atop8918/DigitalWaters_WD_prototype/README.md

# DigitalWaters_WD_prototype
Simplified Schematic for prototype release
