atop8918/DigitalWaters_WD_prototype/board.pdf

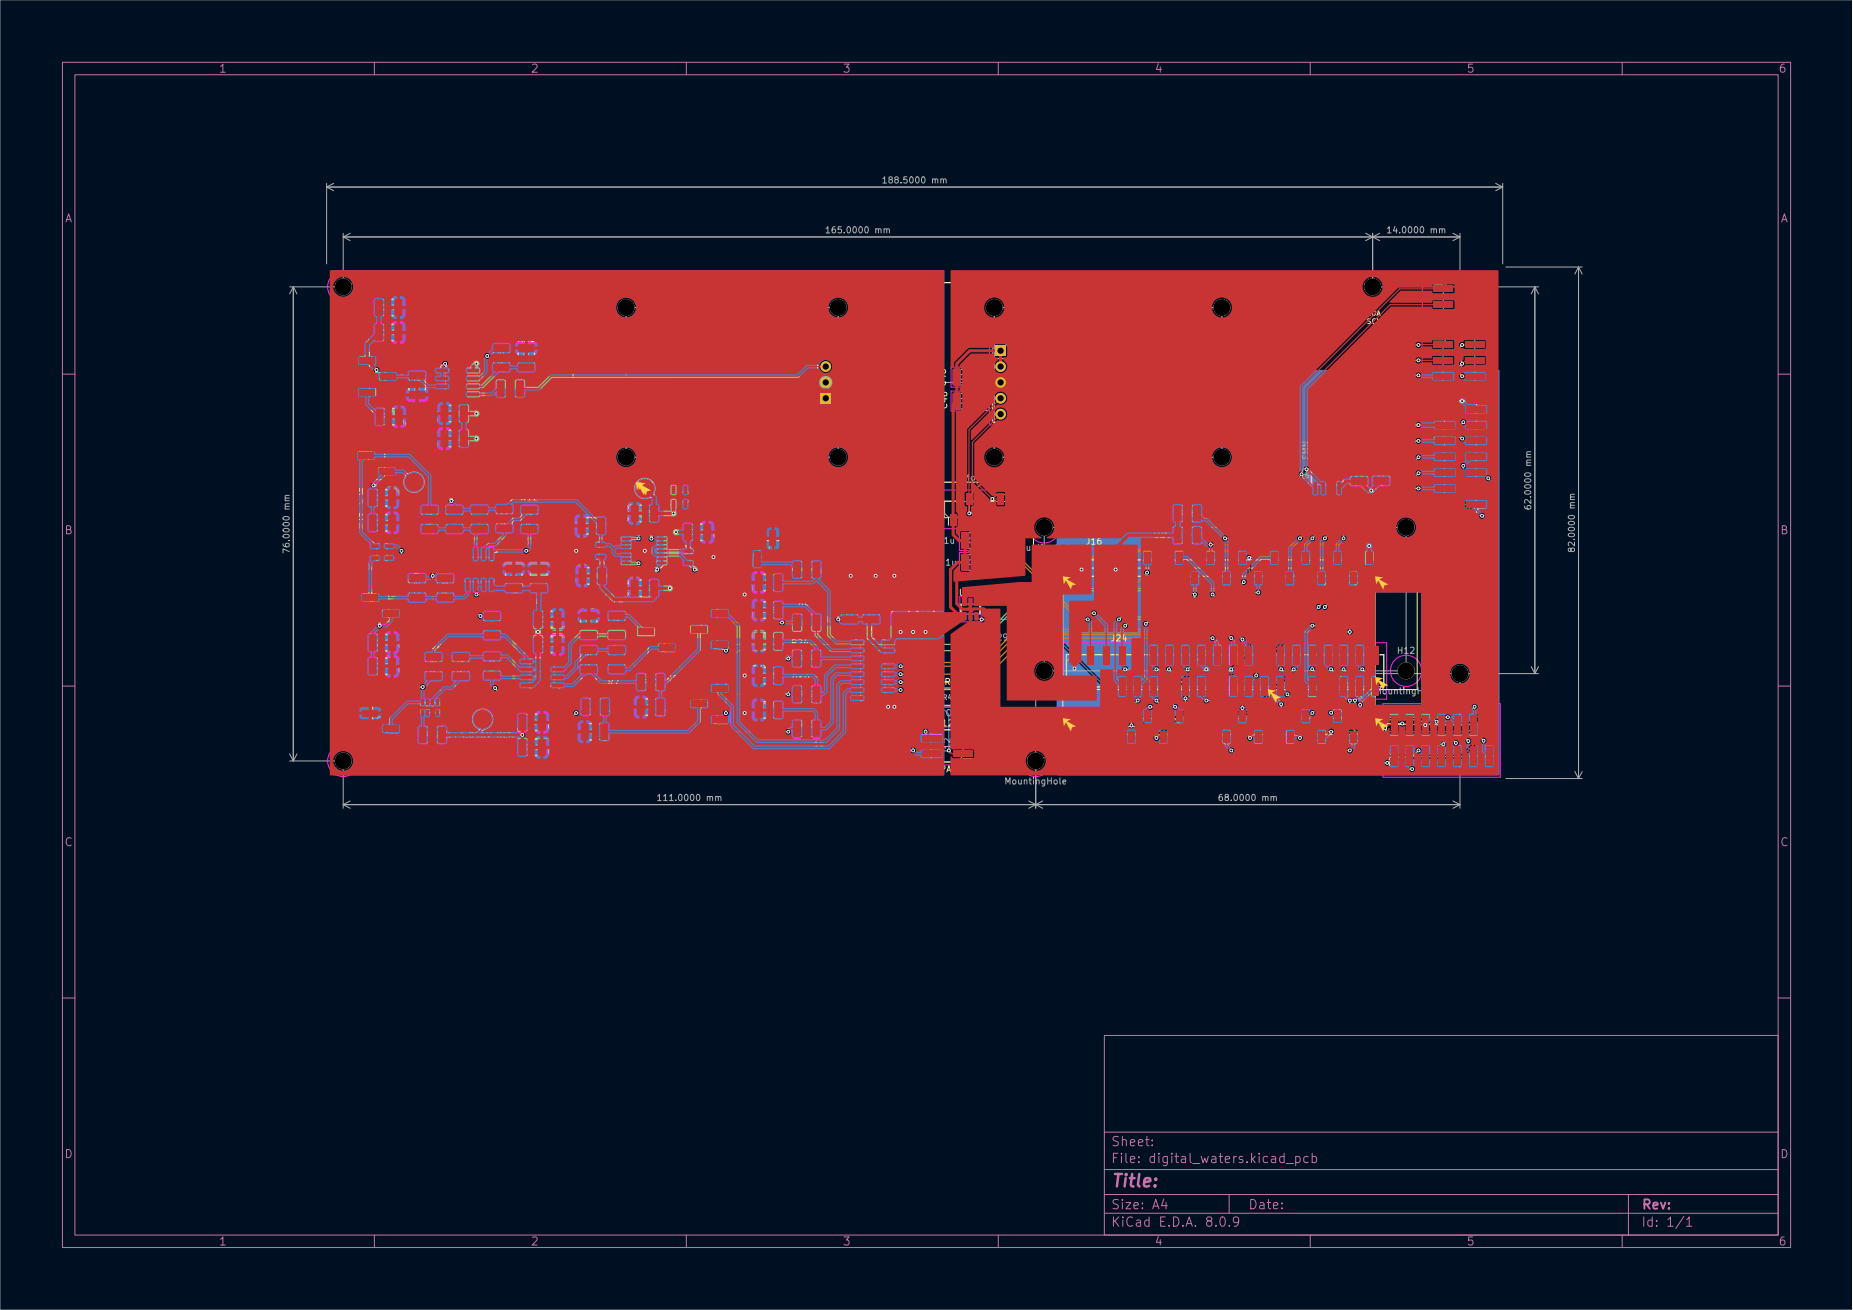
[picture p1: page 1]
