atop8918/DigitalWaters_WD_prototype/digital_waters.kicad_pcb

## KiCad design digital_waters.kicad_pcb (2025-07-22)

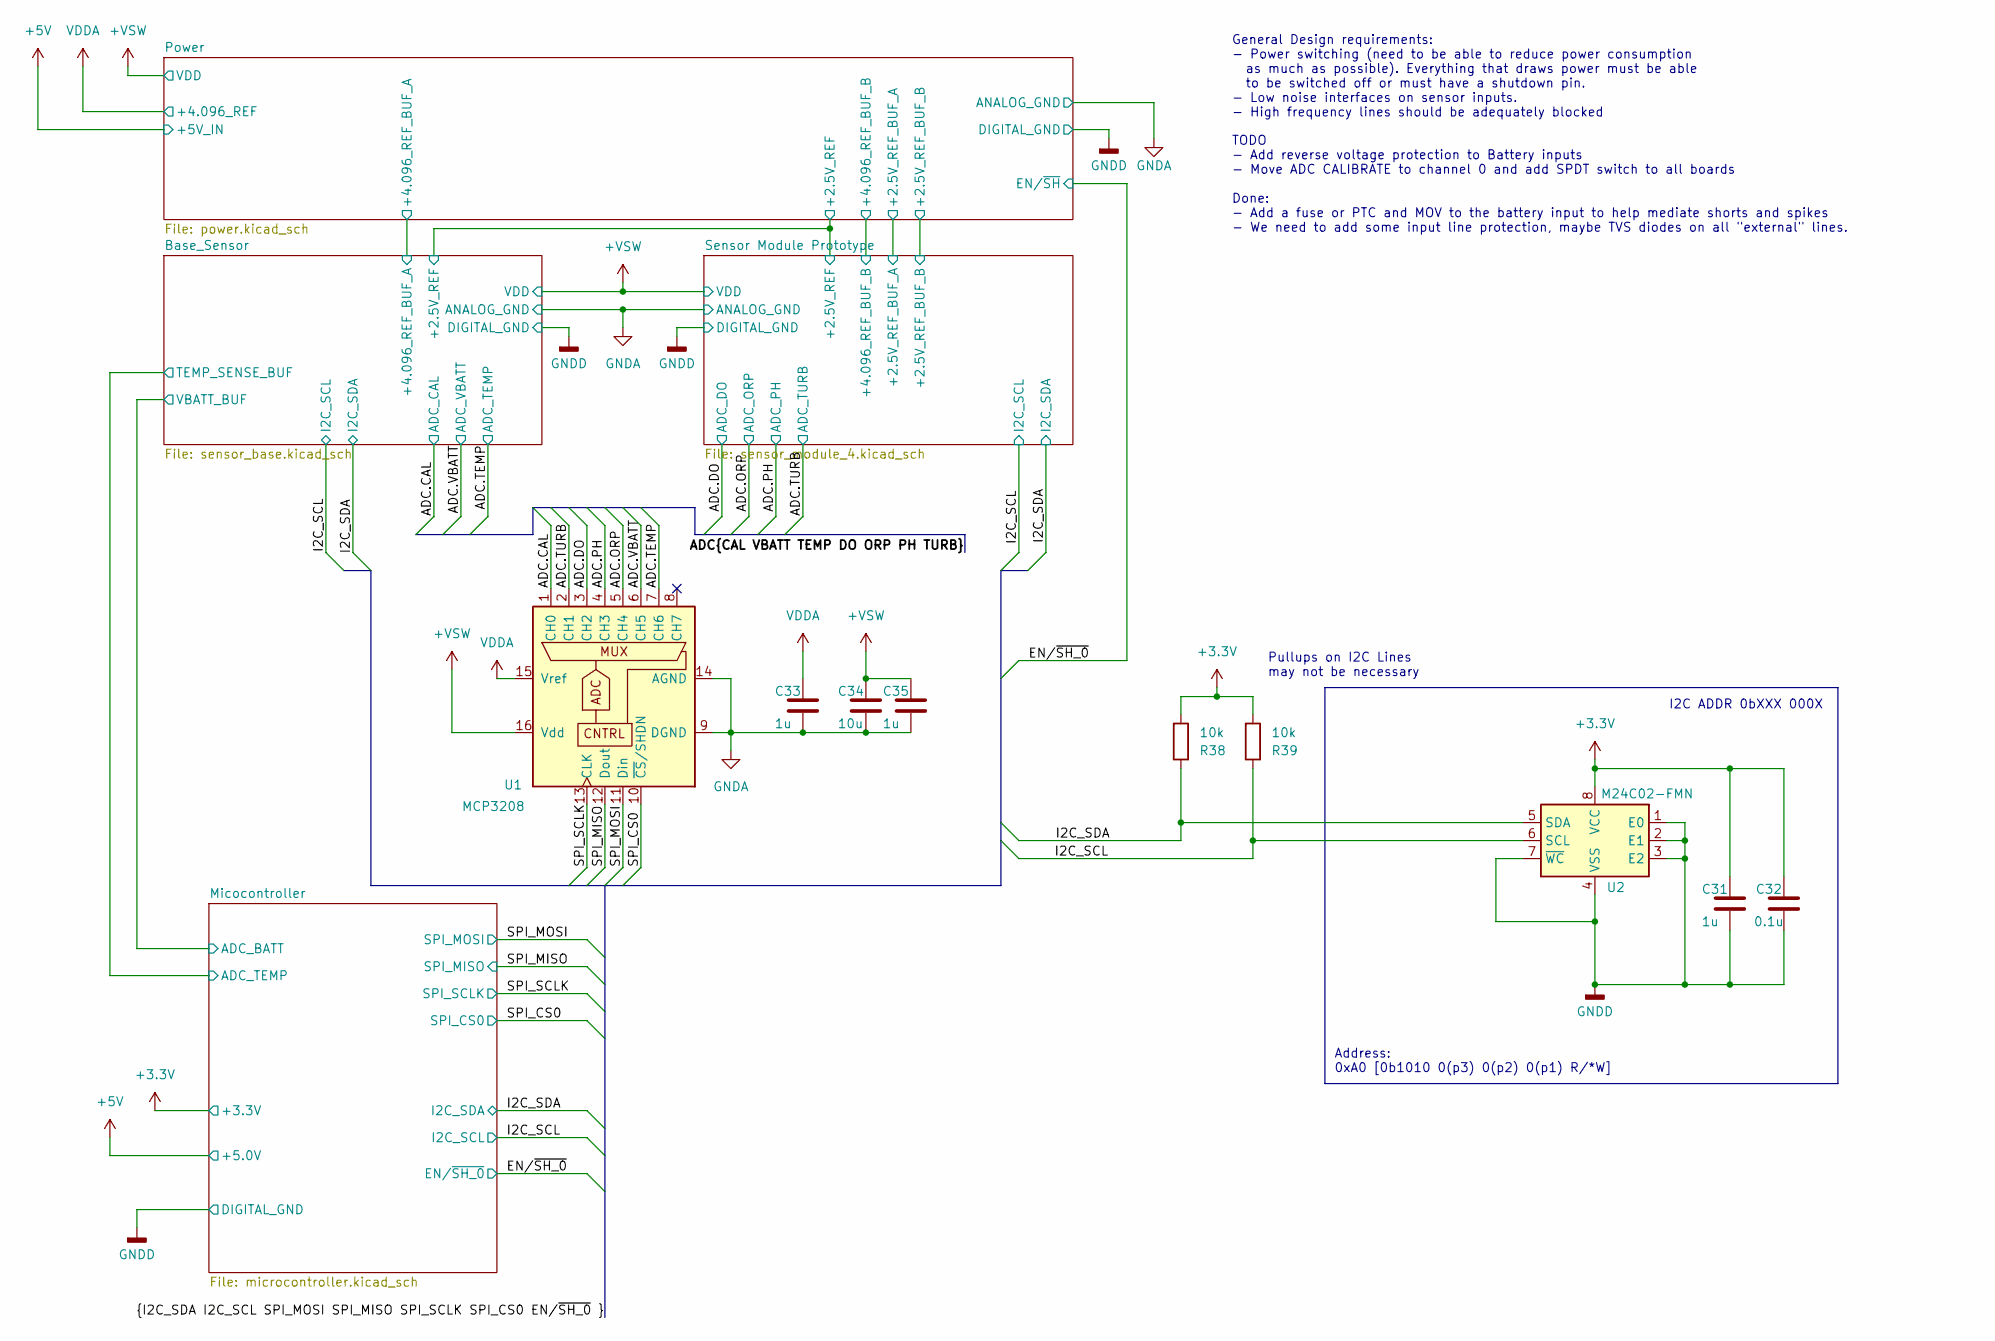
[picture p7: schematic digital_waters.kicad_sch]

Parts:
C31, C33, C35: 1u; C_1210_3225Metric_Pad1.33x2.70mm_HandSolder
C32: 0.1u; C_1210_3225Metric_Pad1.33x2.70mm_HandSolder
C34: 10u; C_1210_3225Metric_Pad1.33x2.70mm_HandSolder
R38, R39: 10k; R_1210_3225Metric_Pad1.30x2.65mm_HandSolder
U1: MCP3208; SOIC-16_3.9x9.9mm_P1.27mm
U2: M24C02-FMN; SOIC-8_3.9x4.9mm_P1.27mm

Connections:
+3.3V: C31.1, C32.1, R38.2, R39.2, U2.8 (VCC); also elsewhere on the board
+VSW: C34.1, C35.1, U1.16 (Vdd); also elsewhere on the board
/ADC.CAL: U1.1 (CH0); also elsewhere on the board
/ADC.DO: U1.3 (CH2); also elsewhere on the board
/ADC.ORP: U1.5 (CH4); also elsewhere on the board
/ADC.PH: U1.4 (CH3); also elsewhere on the board
/ADC.TEMP: U1.7 (CH6); also elsewhere on the board
/ADC.TURB: U1.2 (CH1); also elsewhere on the board
/ADC.VBATT: U1.6 (CH5); also elsewhere on the board
/I2C_SCL: R39.1, U2.6 (SCL); also elsewhere on the board
/I2C_SDA: R38.1, U2.5 (SDA); also elsewhere on the board
/SPI_CS0: U1.10 (~CS/SHDN); also elsewhere on the board
/SPI_MISO: U1.12 (Dout); also elsewhere on the board
/SPI_MOSI: U1.11 (Din); also elsewhere on the board
/SPI_SCLK: U1.13 (CLK); also elsewhere on the board
GNDA: C33.2, C34.2, C35.2, U1.9 (DGND), U1.14 (AGND); also elsewhere on the board
GNDD: C31.2, C32.2, U2.1 (E0), U2.2 (E1), U2.3 (E2), U2.4 (VSS), U2.7 (~WC); also elsewhere on the board
VDDA: C33.1, U1.15 (Vref); also elsewhere on the board

Notes on the sheet:
I2C ADDR 0bXXX 000X
Address: 0xA0 [0b1010 0(p3) 0(p2) 0(p1) R/*W]
TODO - Add reverse voltage protection to Battery inputs - Move ADC CALIBRATE to channel 0 and add SPDT switch to all boards Done: - Add a fuse or PTC and MOV to the battery input to help mediate shorts and spikes - We need to add some input line protection, maybe TVS diodes on all "external" lines.
Pullups on I2C Lines may not be necessary
General Design requirements: - Power switching (need to be able to reduce power consumption as much as possible). Everything that draws power must be able to be switched off or must have a shutdown pin. - Low noise interfaces on sensor inputs. - High frequency lines should be adequately blocked

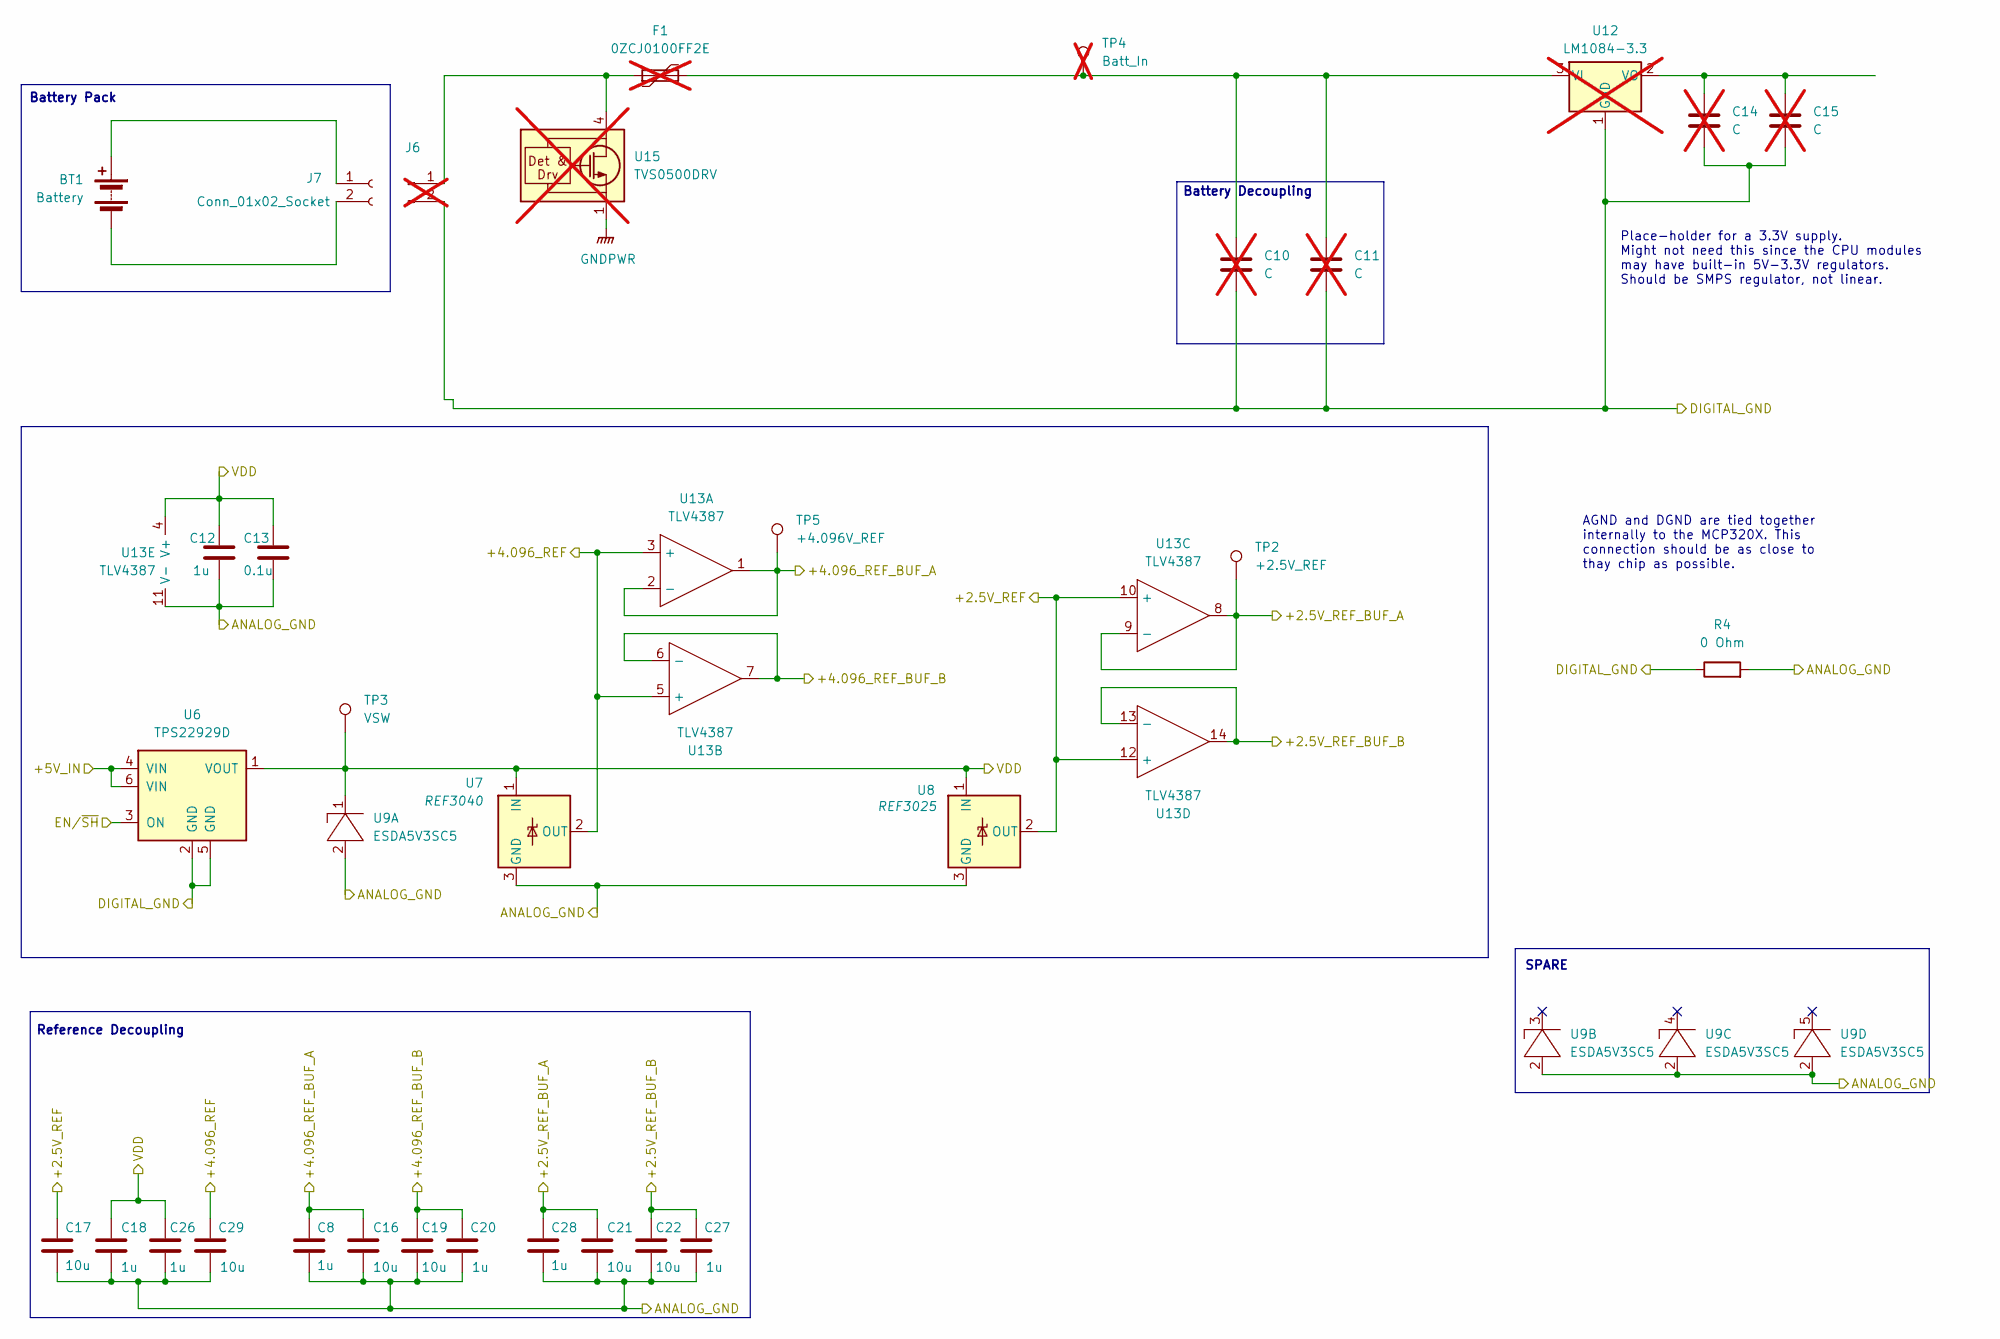
[picture p8: schematic power.kicad_sch]

Parts:
BT1: Battery
C8, C12, C18, C20, C26, C27, C28: 1u; C_1210_3225Metric_Pad1.33x2.70mm_HandSolder
C10, C11, C14, C15: C; C_1210_3225Metric_Pad1.33x2.70mm_HandSolder; not fitted
C13: 0.1u; C_1210_3225Metric_Pad1.33x2.70mm_HandSolder
C16, C17, C19, C21, C22, C29: 10u; C_1210_3225Metric_Pad1.33x2.70mm_HandSolder
F1: 0ZCJ0100FF2E; Fuse_1206_3216Metric_Pad1.42x1.75mm_HandSolder; not fitted
J6: Battery In; PinHeader_1x02_P2.54mm_Vertical_SMD_Pin1Left; not fitted
J7: Conn_01x02_Socket
R4: 0 Ohm; R_1210_3225Metric_Pad1.30x2.65mm_HandSolder
TP2: +2.5V_REF; TestPoint_Pad_D3.0mm
TP3: VSW; TestPoint_Pad_D3.0mm
TP4: Batt_In; TestPoint_Pad_D3.0mm; not fitted
TP5: +4.096V_REF; TestPoint_Pad_D3.0mm
U6: TPS22929D; SOT-23-6
U7: REF3040; SOT-23
U8: REF3025; SOT-23
U9: ESDA5V3SC5; SOT-23-5
U12: LM1084-3.3; PinHeader_2x10_P2.54mm_Vertical_SMD; not fitted
U13: TLV4387; TSSOP-14_4.4x5mm_P0.65mm
U15: TVS0500DRV; WSON-6-1EP_2x2mm_P0.65mm_EP1x1.6mm; not fitted

Connections:
+5V: U6.4 (VIN), U6.6 (VIN); also elsewhere on the board
+VSW: C12.1, C13.1, C18.1, C26.1, TP3.1, U6.1 (VOUT), U7.1 (IN), U8.1 (IN), U9.1, U13.4 (V+); also elsewhere on the board
/Base_Sensor/+2.5V_REF: C17.1, U8.2 (OUT), U13.10 (+), U13.12 (+); also elsewhere on the board
/Base_Sensor/+4.096_REF_BUF_A: C8.1, C16.1, TP5.1, U13.1, U13.2 (-); also elsewhere on the board
/EN/~SH_0: U6.3 (ON); also elsewhere on the board
/Power/+2.5V_REF_BUF_A: C21.1, C28.1, TP2.1, U13.8, U13.9 (-); also elsewhere on the board
/Power/+2.5V_REF_BUF_B: C22.1, C27.1, U13.13 (-), U13.14; also elsewhere on the board
/Power/+4.096_REF_BUF_B: C19.1, C20.1, U13.6 (-), U13.7; also elsewhere on the board
GNDA: C8.2, C12.2, C13.2, C16.2, C17.2, C18.2, C19.2, C20.2, C21.2, C22.2, C26.2, C27.2, C28.2, C29.2, R4.2, U7.3 (GND), U8.3 (GND), U9.2, U13.11 (V-); also elsewhere on the board
GNDD: C10.2, C11.2, C14.2, C15.2, J6.2, R4.1, U6.2 (GND), U6.5 (GND), U12.1 (GND); also elsewhere on the board
unnamed: BT1.1 (+), J7.1
unnamed: BT1.2 (-), J7.2
unnamed: C10.1, C11.1, F1.2, TP4.1, U12.3 (VI)
unnamed: C14.1, C15.1, U12.2 (VO)
unnamed: F1.1, J6.1, U15.4 (IN), U15.5 (IN), U15.6 (IN)
unnamed: U15.1 (GND), U15.2 (GND), U15.3 (GND), U15.7 (GND)
VDDA: C29.1, U7.2 (OUT), U13.3 (+), U13.5 (+); also elsewhere on the board

Notes on the sheet:
Battery Pack
Place-holder for a 3.3V supply. Might not need this since the CPU modules may have built-in 5V-3.3V regulators. Should be SMPS regulator, not linear.
Battery Decoupling
AGND and DGND are tied together internally to the MCP320X. This connection should be as close to thay chip as possible.
SPARE
Reference Decoupling

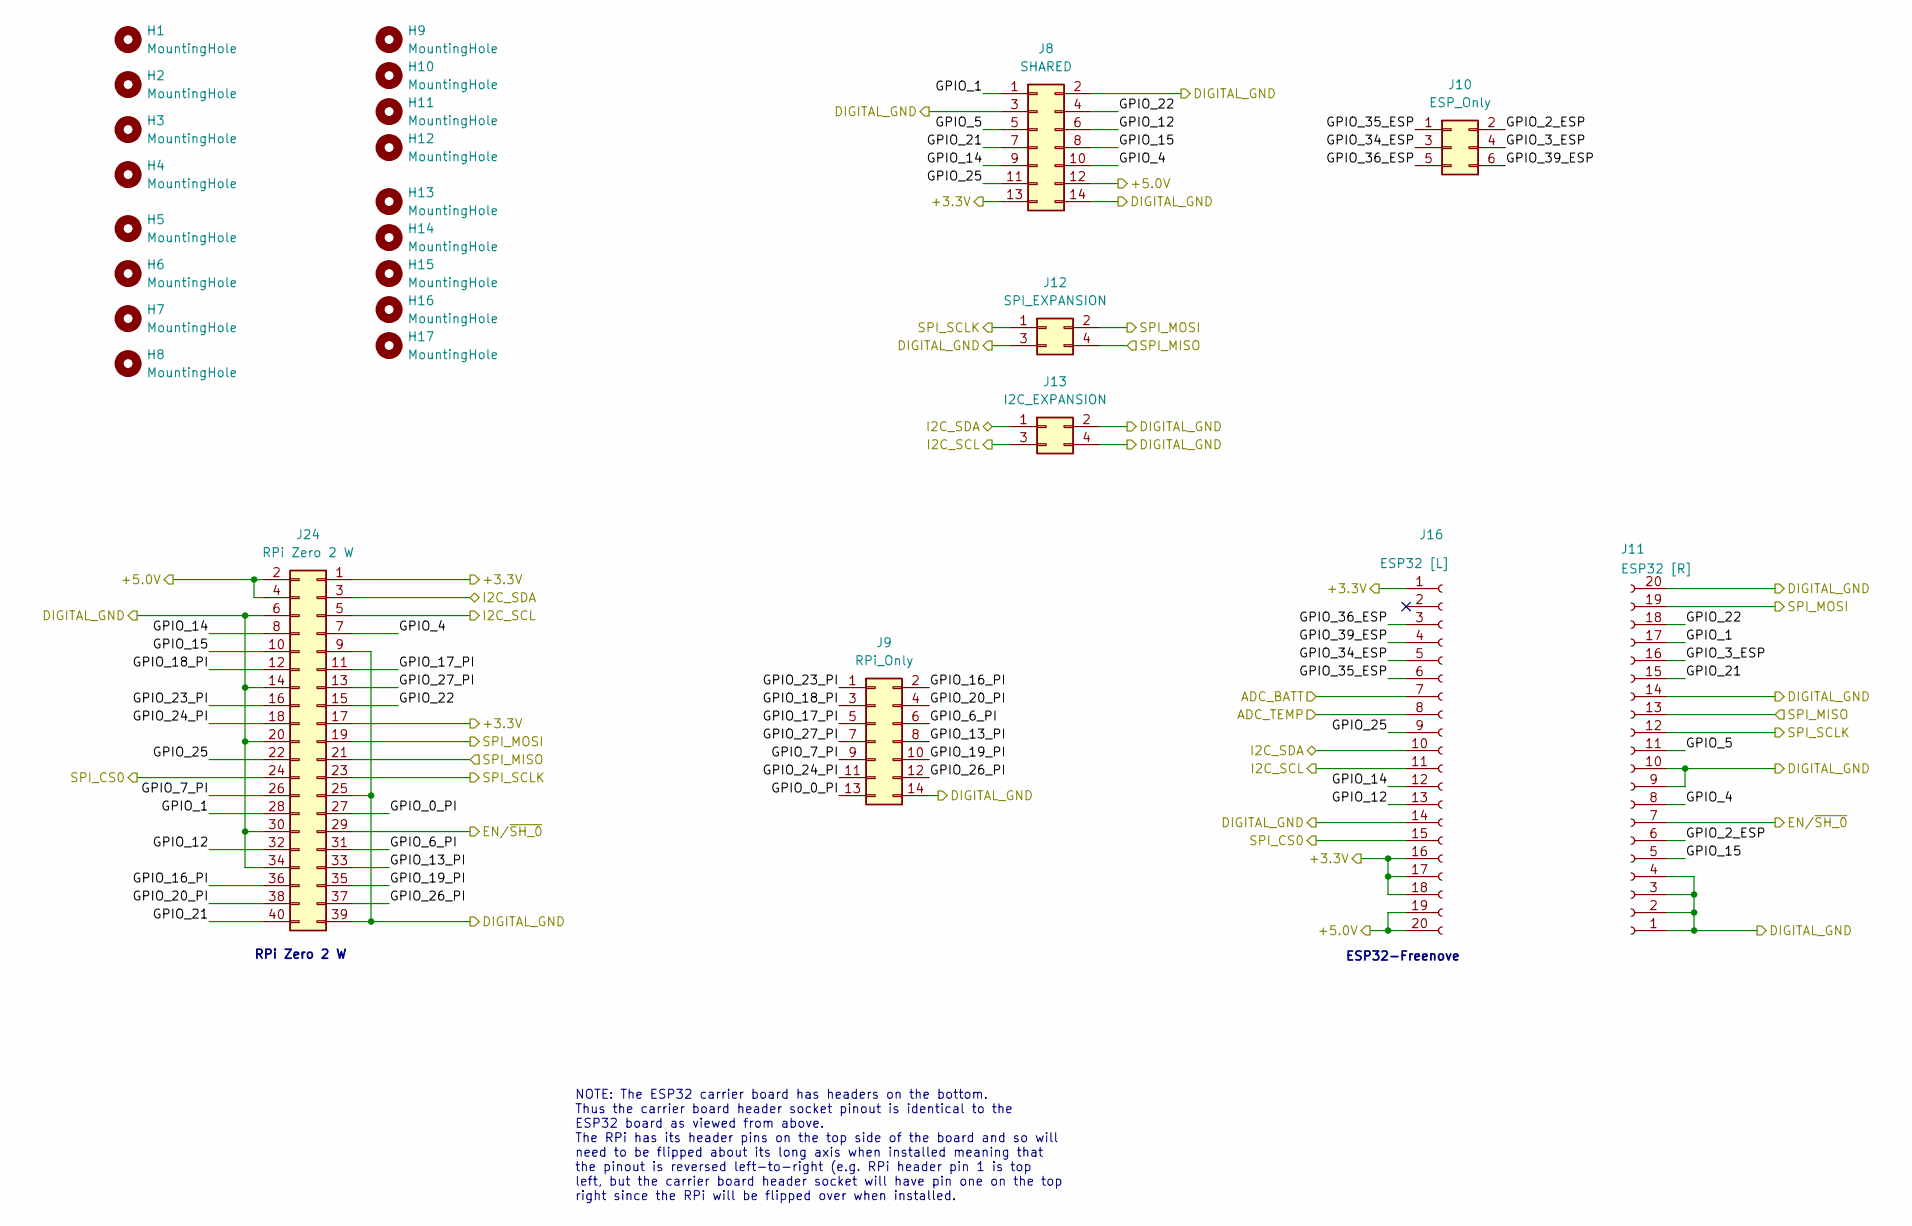
[picture p9: schematic microcontroller.kicad_sch]

Parts:
H1, H2, H3, H4, H5, H6, H7, H8, H9, H10, H11, H12, H13, H14, H15, H16, H17: MountingHole; MountingHole_2.7mm_M2.5_ISO14580
J8: SHARED; PinHeader_2x07_P2.54mm_Vertical_SMD
J9: RPi_Only; PinHeader_2x07_P2.54mm_Vertical_SMD
J10: ESP_Only; PinHeader_2x03_P2.54mm_Vertical_SMD
J11: ESP32 [R]; PinSocket_1x20_P2.54mm_Vertical_SMD_Pin1Left
J12: SPI_EXPANSION; PinHeader_2x02_P2.54mm_Vertical_SMD
J13: I2C_EXPANSION; PinHeader_2x02_P2.54mm_Vertical_SMD
J16: ESP32 [L]; PinSocket_1x20_P2.54mm_Vertical_SMD_Pin1Left
J24: RPi Zero 2 W; PinSocket_2x20_P2.54mm_Vertical_SMD

Connections:
+3.3V: J8.13, J16.1, J16.16, J16.17, J16.18, J24.1, J24.17; also elsewhere on the board
+5V: J8.12, J16.19, J16.20, J24.2, J24.4; also elsewhere on the board
/Base_Sensor/TEMP_SENSE_BUF: J16.8; also elsewhere on the board
/Base_Sensor/VBATT_BUF: J16.7; also elsewhere on the board
/EN/~SH_0: J11.7, J24.29; also elsewhere on the board
/I2C_SCL: J13.3, J16.11, J24.5; also elsewhere on the board
/I2C_SDA: J13.1, J16.10, J24.3; also elsewhere on the board
/Micocontroller/GPIO_0_PI: J9.13, J24.27
/Micocontroller/GPIO_1: J8.1, J11.17, J24.28
/Micocontroller/GPIO_2_ESP: J10.2, J11.6
/Micocontroller/GPIO_3_ESP: J10.4, J11.16
/Micocontroller/GPIO_4: J8.10, J11.8, J24.7
/Micocontroller/GPIO_5: J8.5, J11.11
/Micocontroller/GPIO_6_PI: J9.6, J24.31
/Micocontroller/GPIO_7_PI: J9.9, J24.26
/Micocontroller/GPIO_12: J8.6, J16.13, J24.32
/Micocontroller/GPIO_13_PI: J9.8, J24.33
/Micocontroller/GPIO_14: J8.9, J16.12, J24.8
/Micocontroller/GPIO_15: J8.8, J11.5, J24.10
/Micocontroller/GPIO_16_PI: J9.2, J24.36
/Micocontroller/GPIO_17_PI: J9.5, J24.11
/Micocontroller/GPIO_18_PI: J9.3, J24.12
/Micocontroller/GPIO_19_PI: J9.10, J24.35
/Micocontroller/GPIO_20_PI: J9.4, J24.38
/Micocontroller/GPIO_21: J8.7, J11.15, J24.40
/Micocontroller/GPIO_22: J8.4, J11.18, J24.15
/Micocontroller/GPIO_23_PI: J9.1, J24.16
/Micocontroller/GPIO_24_PI: J9.11, J24.18
/Micocontroller/GPIO_25: J8.11, J16.9, J24.22
/Micocontroller/GPIO_26_PI: J9.12, J24.37
/Micocontroller/GPIO_27_PI: J9.7, J24.13
/Micocontroller/GPIO_34_ESP: J10.3, J16.5
/Micocontroller/GPIO_35_ESP: J10.1, J16.6
/Micocontroller/GPIO_36_ESP: J10.5, J16.3
/Micocontroller/GPIO_39_ESP: J10.6, J16.4
/SPI_CS0: J16.15, J24.24; also elsewhere on the board
/SPI_MISO: J11.13, J12.4, J24.21; also elsewhere on the board
/SPI_MOSI: J11.19, J12.2, J24.19; also elsewhere on the board
/SPI_SCLK: J11.12, J12.1, J24.23; also elsewhere on the board
GNDD: J8.2, J8.3, J8.14, J9.14, J11.1, J11.2, J11.3, J11.4, J11.9, J11.10, J11.14, J11.20, J12.3, J13.2, J13.4, J16.14, J24.6, J24.9, J24.14, J24.20, J24.25, J24.30, J24.34, J24.39; also elsewhere on the board

Notes on the sheet:
ESP32-Freenove
RPi Zero 2 W
NOTE: The ESP32 carrier board has headers on the bottom. Thus the carrier board header socket pinout is identical to the ESP32 board as viewed from above. The RPi has its header pins on the top side of the board and so will need to be flipped about its long axis when installed meaning that the pino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

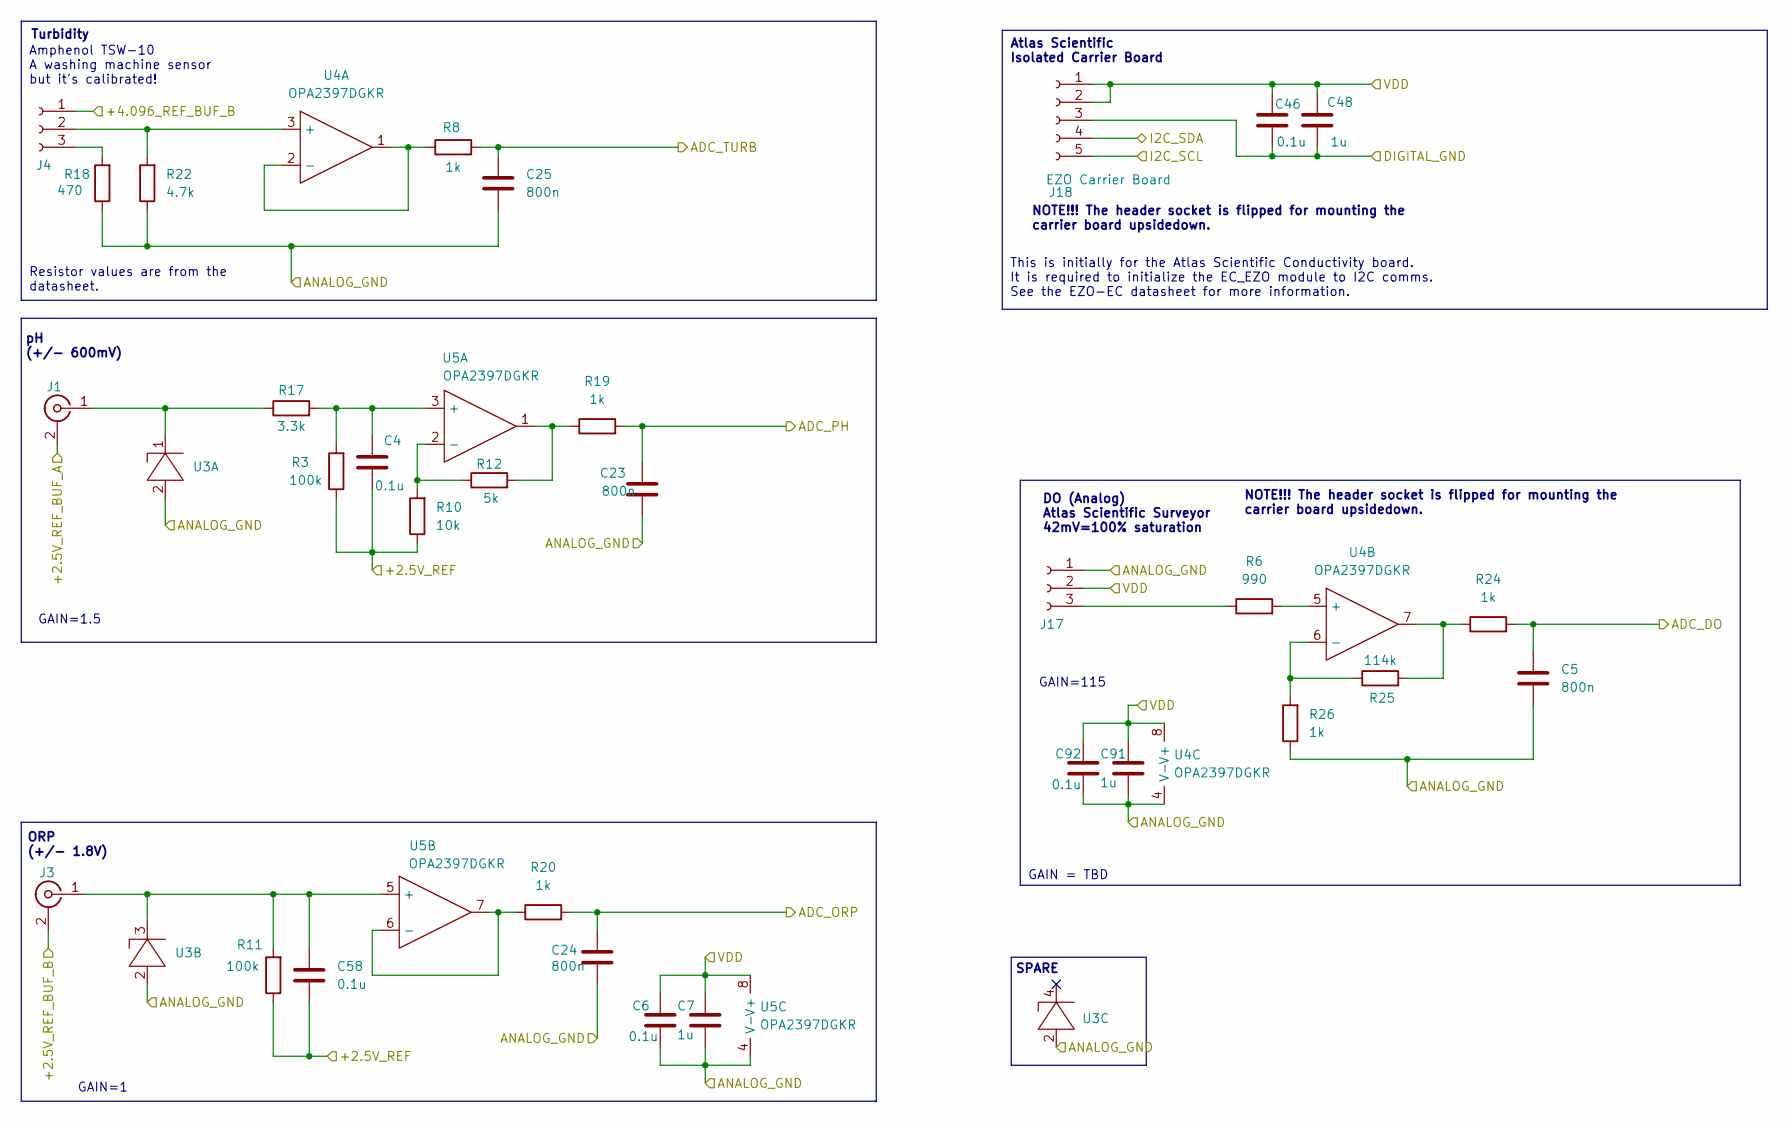
[picture p10: schematic sensor_module_4.kicad_sch]

Parts:
C4, C6, C46, C58, C92: 0.1u; C_1210_3225Metric_Pad1.33x2.70mm_HandSolder
C5, C23, C24, C25: 800n; C_1210_3225Metric_Pad1.33x2.70mm_HandSolder
C7, C48, C91: 1u; C_1210_3225Metric_Pad1.33x2.70mm_HandSolder
J1: pH_IN; PinHeader_1x02_P2.54mm_Vertical_SMD_Pin1Left
J3: ORP_In; PinHeader_1x02_P2.54mm_Vertical_SMD_Pin1Left
J4: Turbidity TSW-10; PinHeader_1x03_P2.54mm_Vertical_SMD_Pin1Left
J17: Atlas Surveyor; PinSocket_1x03_P2.54mm_Vertical
J18: EZO Carrier Board; PinSocket_1x05_P2.54mm_Vertical
R3, R11: 100k; R_1210_3225Metric_Pad1.30x2.65mm_HandSolder
R6: 990; R_1210_3225Metric_Pad1.30x2.65mm_HandSolder
R8, R19, R20, R24, R26: 1k; R_1210_3225Metric_Pad1.30x2.65mm_HandSolder
R10: 10k; R_1210_3225Metric_Pad1.30x2.65mm_HandSolder
R12: 5k; R_1210_3225Metric_Pad1.30x2.65mm_HandSolder
R17: 3.3k; R_1210_3225Metric_Pad1.30x2.65mm_HandSolder
R18: 470; R_1210_3225Metric_Pad1.30x2.65mm_HandSolder
R22: 4.7k; R_1210_3225Metric_Pad1.30x2.65mm_HandSolder
R25: 114k; R_1210_3225Metric_Pad1.30x2.65mm_HandSolder
U3: ESDA5V3SC5; SOT-23-5
U4, U5: OPA2397DGKR; SOIC-8_3.9x4.9mm_P1.27mm

Connections:
+VSW: C6.1, C7.1, C46.1, C48.1, C91.1, C92.1, J17.2, J18.1, J18.2, U4.8 (V+), U5.8 (V+); also elsewhere on the board
/ADC.DO: C5.1, R24.2; also elsewhere on the board
/ADC.ORP: C24.1, R20.2; also elsewhere on the board
/ADC.PH: C23.1, R19.2; also elsewhere on the board
/ADC.TURB: C25.1, R8.2; also elsewhere on the board
/Base_Sensor/+2.5V_REF: C4.2, C58.2, R3.1, R10.1, R11.1; also elsewhere on the board
/I2C_SCL: J18.5; also elsewhere on the board
/I2C_SDA: J18.4; also elsewhere on the board
/Power/+2.5V_REF_BUF_A: J1.2 (Ext); also elsewhere on the board
/Power/+2.5V_REF_BUF_B: J3.2 (Ext); also elsewhere on the board
/Power/+4.096_REF_BUF_B: J4.1; also elsewhere on the board
GNDA: C5.2, C6.2, C7.2, C23.2, C24.2, C25.2, C91.2, C92.2, J17.1, R18.1, R22.1, R26.1, U3.2, U4.4 (V-), U5.4 (V-); also elsewhere on the board
GNDD: C46.2, C48.2, J18.3; also elsewhere on the board
unnamed: J1.1 (In), R17.1, U3.1
unnamed: C58.1, J3.1 (In), R11.2, U3.3, U5.5 (+)
unnamed: J4.2, R22.2, U4.3 (+)
unnamed: J4.3, R18.2
unnamed: J17.3, R6.1
unnamed: R12.2, R19.1, U5.1
unnamed: R24.1, R25.2, U4.7
unnamed: R8.1, U4.1, U4.2 (-)
unnamed: R6.2, U4.5 (+)
unnamed: R25.1, R26.2, U4.6 (-)
unnamed: C4.1, R3.2, R17.2, U5.3 (+)
unnamed: R10.2, R12.1, U5.2 (-)
unnamed: R20.1, U5.6 (-), U5.7

Notes on the sheet:
Atlas Scientific Isolated Carrier Board
Turbidity
NOTE!!! The header socket is flipped for mounting the carrier board upsidedown.
Amphenol TSW-10 A washing machine sensor but it's calibrated!
GAIN=1.5
GAIN=1
Resistor values are from the datasheet.
ORP (+/- 1.8V)
pH (+/- 600mV)
GAIN = TBD
DO (Analog) Atlas Scientific Surveyor 42mV=100% saturation
This is initially for the Atlas Scientific Conductivity board. It is required to initialize the EC_EZO module to I2C comms. See the EZO-EC datasheet for more information.
SPARE
GAIN=115

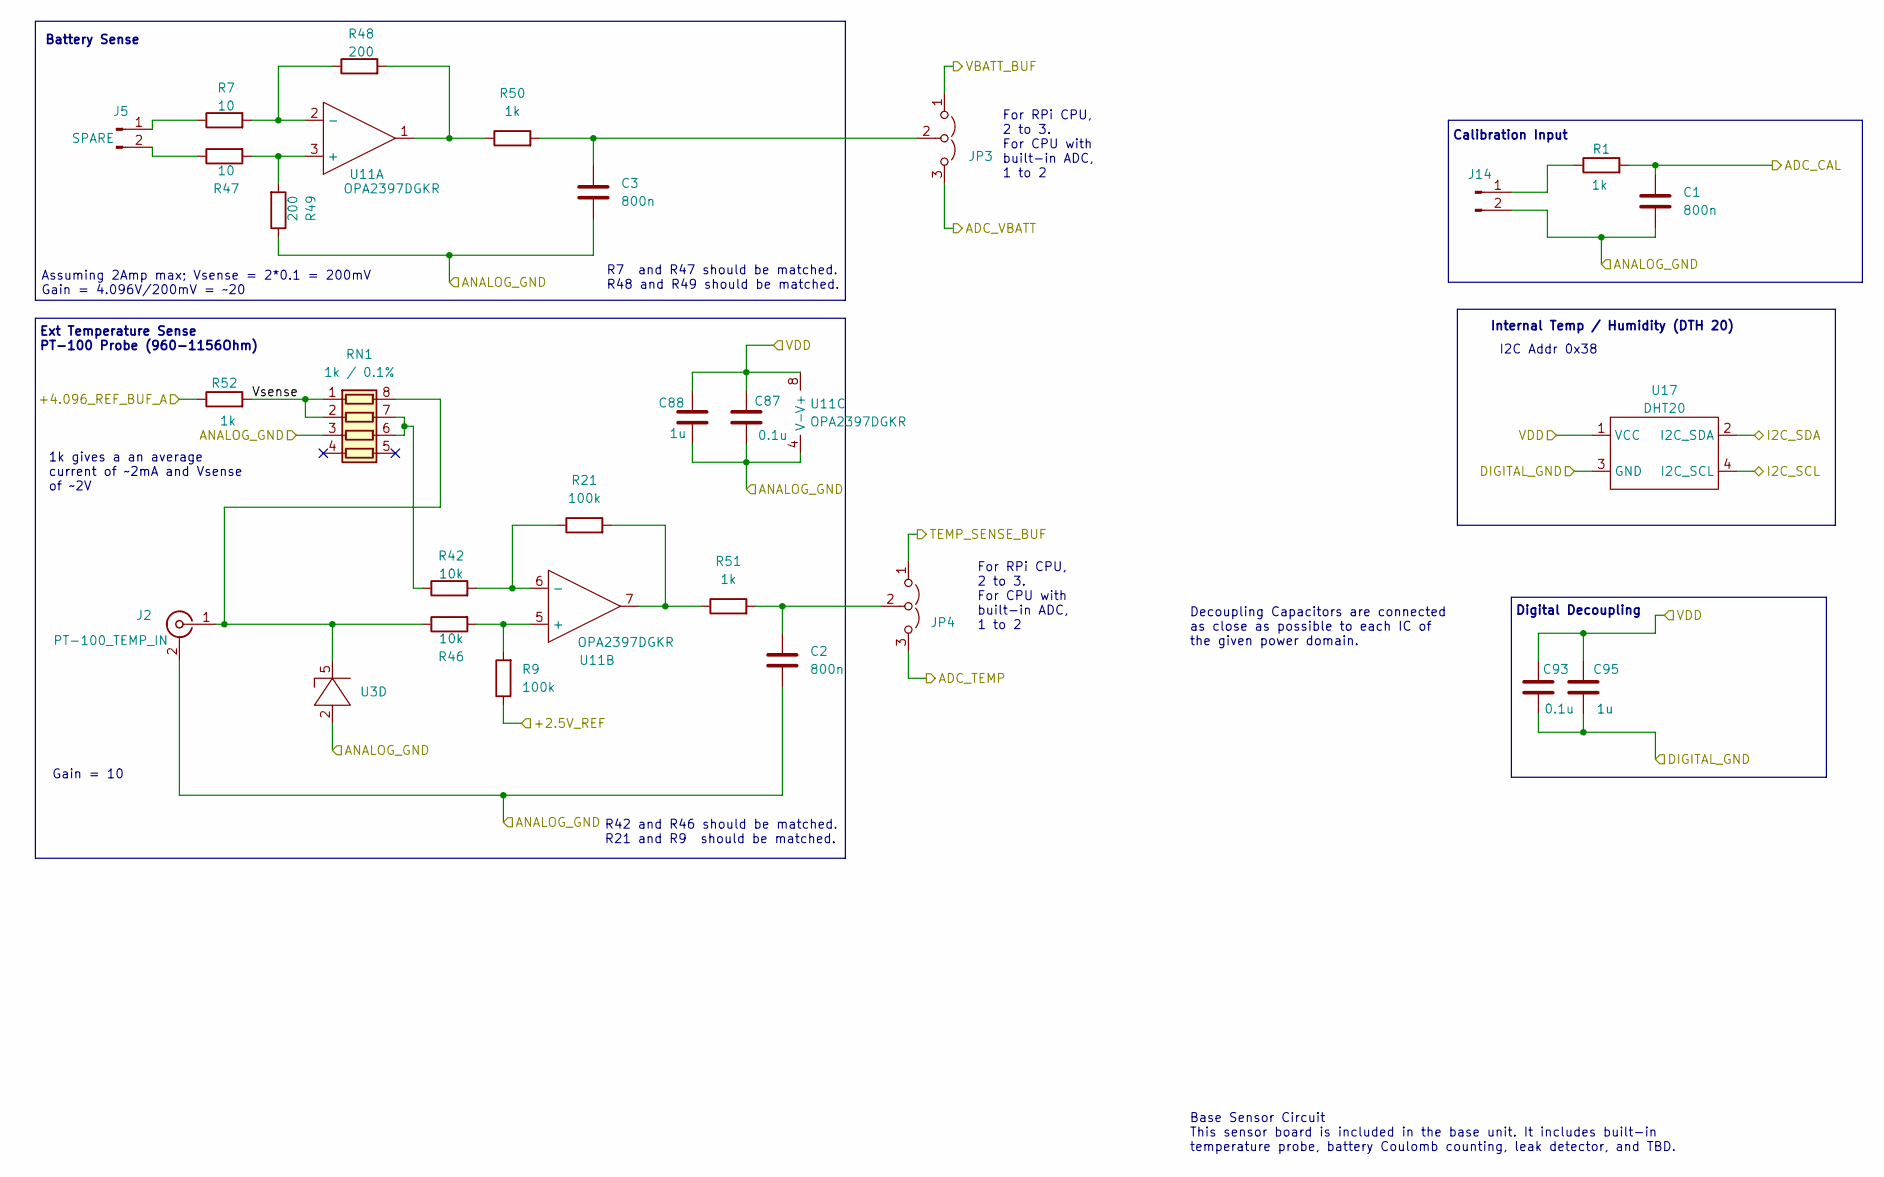
[picture p11: schematic sensor_base.kicad_sch]

Parts:
C1, C2, C3: 800n; C_1210_3225Metric_Pad1.33x2.70mm_HandSolder
C87, C93: 0.1u; C_1210_3225Metric_Pad1.33x2.70mm_HandSolder
C88, C95: 1u; C_1210_3225Metric_Pad1.33x2.70mm_HandSolder
J2: PT-100_TEMP_IN; PinHeader_1x02_P2.54mm_Vertical_SMD_Pin1Left
J5: SPARE; PinHeader_1x02_P2.54mm_Vertical_SMD_Pin1Left
J14: Calibration_In; PinHeader_1x02_P2.54mm_Vertical_SMD_Pin1Left
JP3: RPi_Batt; PinHeader_1x03_P2.54mm_Vertical_SMD_Pin1Left
JP4: RPi_Temp; PinHeader_1x03_P2.54mm_Vertical_SMD_Pin1Left
R1, R50, R51, R52: 1k; R_1210_3225Metric_Pad1.30x2.65mm_HandSolder
R7, R47: 10; R_1210_3225Metric_Pad1.30x2.65mm_HandSolder
R9, R21: 100k; R_1210_3225Metric_Pad1.30x2.65mm_HandSolder
R42, R46: 10k; R_1210_3225Metric_Pad1.30x2.65mm_HandSolder
R48, R49: 200; R_1210_3225Metric_Pad1.30x2.65mm_HandSolder
RN1: 1k / 0.1%; R_Array_Concave_4x0603
U3: ESDA5V3SC5; SOT-23-5
U11: OPA2397DGKR; SOIC-8_3.9x4.9mm_P1.27mm
U17: DHT20; PinSocket_1x04_P2.54mm_Vertical_SMD_Pin1Left

Connections:
+VSW: C87.1, C88.1, C93.1, C95.1, U11.8 (V+), U17.1 (VCC); also elsewhere on the board
/ADC.CAL: C1.1, R1.2; also elsewhere on the board
/ADC.TEMP: JP4.3 (B); also elsewhere on the board
/ADC.VBATT: JP3.3 (B); also elsewhere on the board
/Base_Sensor/+2.5V_REF: R9.1; also elsewhere on the board
/Base_Sensor/+4.096_REF_BUF_A: R52.1; also elsewhere on the board
/Base_Sensor/TEMP_SENSE_BUF: JP4.1 (A); also elsewhere on the board
/Base_Sensor/VBATT_BUF: JP3.1 (A); also elsewhere on the board
/Base_Sensor/Vsense: R52.2, RN1.1 (R1.1), RN1.2 (R2.1)
/I2C_SCL: U17.4 (I2C_SCL); also elsewhere on the board
/I2C_SDA: U17.2 (I2C_SDA); also elsewhere on the board
GNDA: C1.2, C2.2, C3.2, C87.2, C88.2, J2.2 (Ext), J14.2, R49.1, RN1.3 (R3.1), U3.2, U11.4 (V-); also elsewhere on the board
GNDD: C93.2, C95.2, U17.3 (GND); also elsewhere on the board
unnamed: J2.1 (In), R46.1, RN1.8 (R1.2), U3.5
unnamed: J5.1, R7.1
unnamed: J5.2, R47.1
unnamed: J14.1, R1.1
unnamed: C3.1, JP3.2 (C), R50.2
unnamed: C2.1, JP4.2 (C), R51.2
unnamed: R21.2, R51.1, U11.7
unnamed: R48.2, R50.1, U11.1
unnamed: R42.1, RN1.6 (R3.2), RN1.7 (R2.2)
unnamed: R47.2, R49.2, U11.3 (+)
unnamed: R7.2, R48.1, U11.2 (-)
unnamed: R9.2, R46.2, U11.5 (+)
unnamed: R21.1, R42.2, U11.6 (-)

Notes on the sheet:
Battery Sense
Decoupling Capacitors are connected as close as possible to each IC of the given power domain.
I2C Addr 0x38
Calibration Input
For RPi CPU, 2 to 3. For CPU with built-in ADC, 1 to 2
Gain = 10
Digital Decoupling
Assuming 2Amp max; Vsense = 2*0.1 = 200mV Gain = 4.096V/200mV = ~20
Base Sensor Circuit This sensor board is included in the base unit. It includes built-in temperature probe, battery Coulomb counting, leak detector, and TBD.
Internal Temp / Humidity (DTH 20)
Ext Temperature Sense PT-100 Probe (960-1156Ohm)
R42 and R46 should be matched. R21 and R9 should be matched.
R7 and R47 should be matched. R48 and R49 should be matched.
1k gives a an average current of ~2mA and Vsense of ~2V

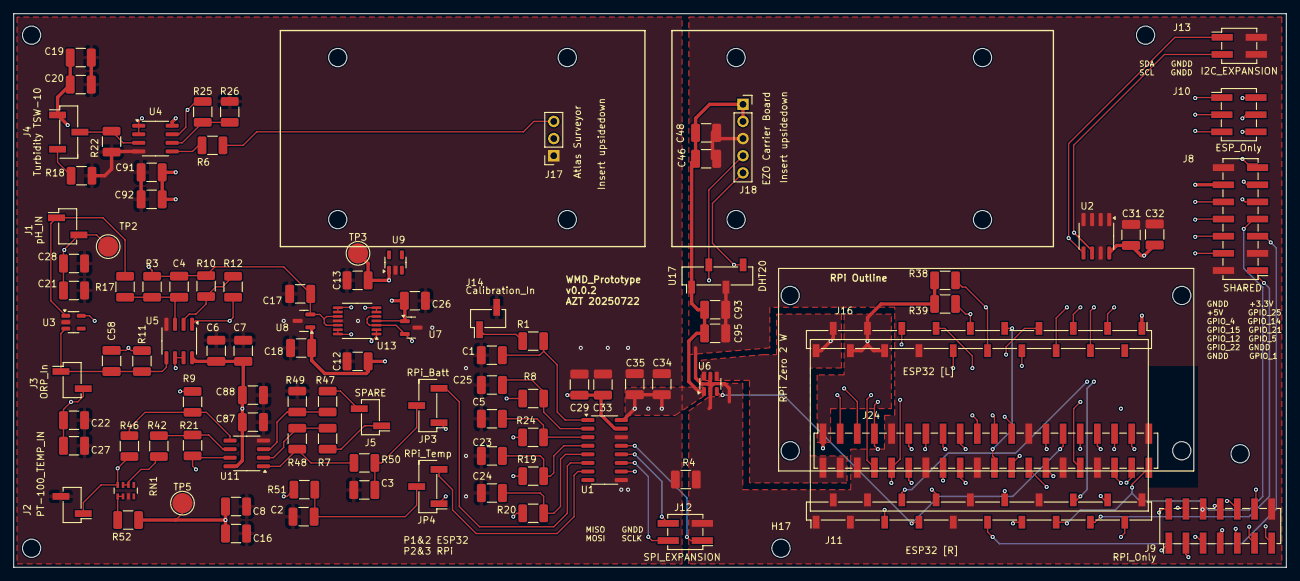
[picture p12: board digital_waters.kicad_pcb from above]

Board: 4 copper layers, 188.5 x 82.0 mm, 118 parts (0 on the bottom side), 82 nets.
