atop8918/DigitalWaters_WD_prototype/(commit log)

2025-06-19 Inception A little late, but the prototype board and schematic mostly ready for gerbers and manufacturing. Some somponent values still need to be defined but this is a BOM issue, not a board issue.
    [conductivity_4.kicad_sch, digital_sensor_4.kicad_sch, digital_waters.kicad_pcb, digital_waters.kicad_sch, microcontroller.kicad_sch, power.kicad_sch, sensor.kicad_sch, sensor_base.kicad_sch]
2025-06-19 Added board mounting holes, basic dimensions, and a board pdf file for casual viewing.
    [digital_waters.kicad_pcb, microcontroller.kicad_sch]
2025-06-19 Added some silkscreen comments. Added a keepout for the ESP32 antenna.
    [digital_waters.kicad_pcb]
2025-06-19 Forgot to add the board pdf...
2025-06-19 Generated gerbers
    [digital_waters-B_Cu.gbr, digital_waters-B_Mask.gbr, digital_waters-B_Paste.gbr, digital_waters-B_Silkscreen.gbr, digital_waters-Edge_Cuts.gbr, digital_waters-F_Cu.gbr, digital_waters-F_Mask.gbr, digital_waters-F_Paste.gbr]
2025-07-22 BUG_FIX ------- - Swapped ground for the 2.5V reference on the non-inverting leg of U11B (External temperature probe) This is due to the fact that the temp probe voltage can go both above and below t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
    FEATURES
    --------
    - Finalized many of the parts for the BOM
    [digital_waters.kicad_pcb, digital_waters.kicad_sch, digital_waters.ods, microcontroller.kicad_sch, power.kicad_sch, sensor_base.kicad_sch, sensor_module_4.kicad_sch]
